asmirnou/gardtec-keypad/gardtec/gardtec.pdf

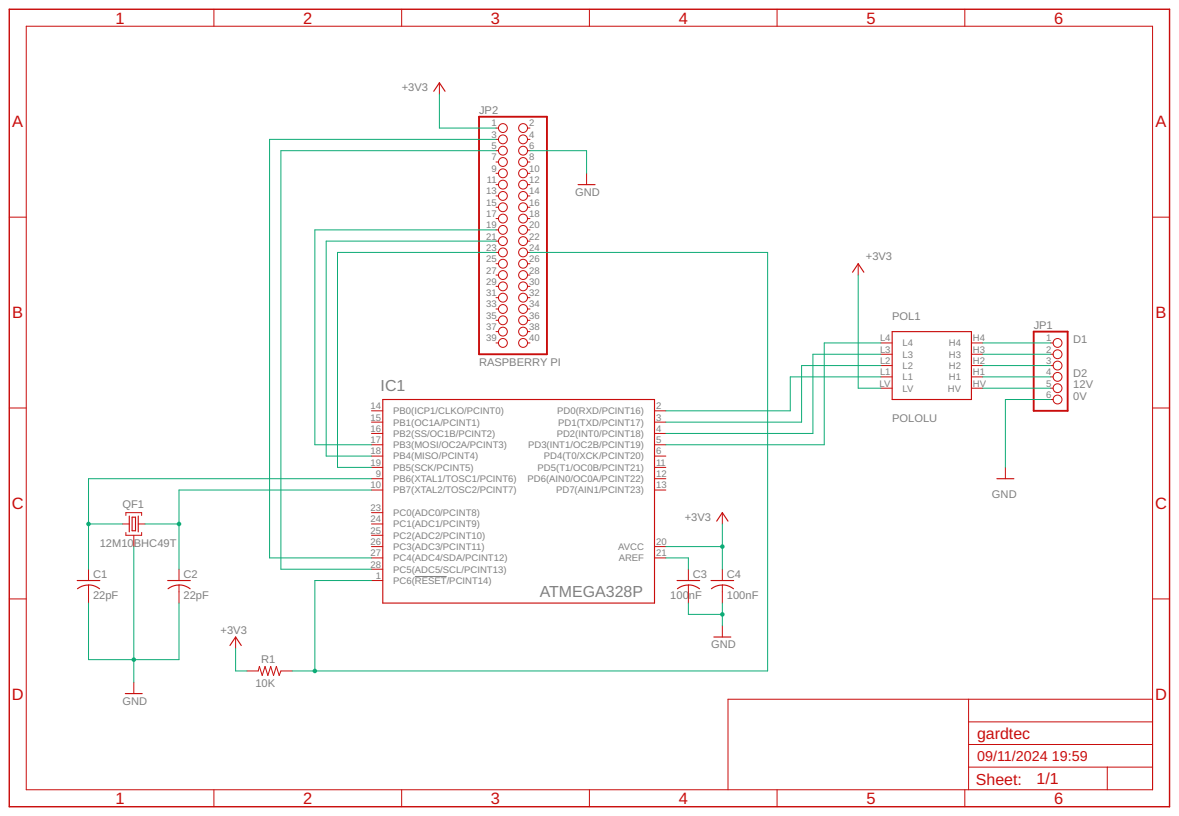
[picture p2: page 1]
