asmirnou/gardtec-keypad/gardtec/gardtec.sch

## EAGLE design gardtec/gardtec.sch (2024-11-09)

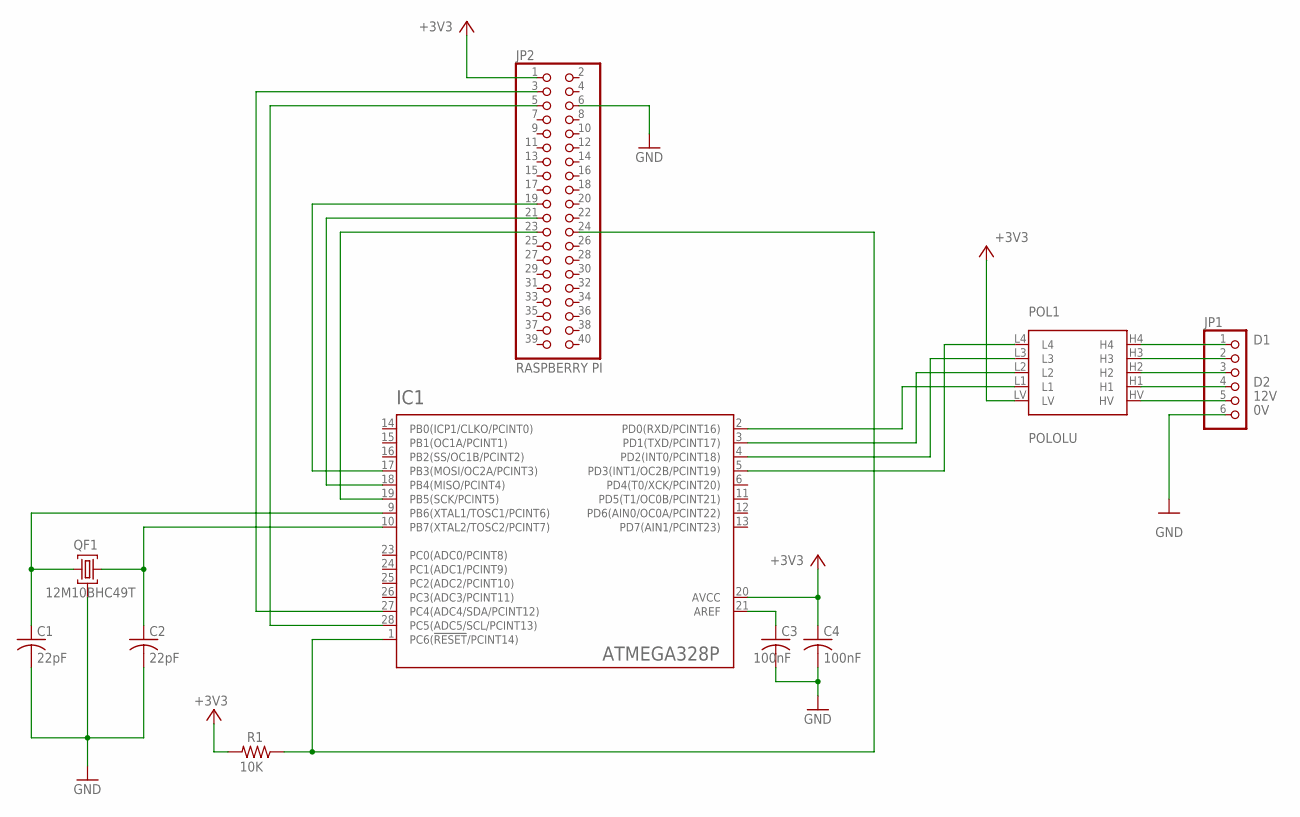
[picture p3: schematic gardtec.sch]

Parts:
C1, C2: 22pF; C0805
C3, C4: 100nF; C0805
IC1: ATMEGA328P; DIL28
JP1: PINHD-1X6; 1X06
JP2: RASPBERRY PI; 2X20
POL1: POLOLU
QF1: 12M10BHC49T; HC49U
R1: 10K; R0805

Connections:
0V: C1.2, C2.2, C3.2, C4.2, JP1.6, QF1.2
12V: JP1.5, POL1.HV
+3V3: C4.1, IC1.20 (AVCC), JP2.1, POL1.LV, R1.2
D1: JP1.1, POL1.H4
D2: JP1.4, POL1.H1
GND: JP2.6
unnamed: IC1.2 (PD0(RXD/PCINT16)), POL1.L1
unnamed: IC1.3 (PD1(TXD/PCINT17)), POL1.L2
unnamed: IC1.4 (PD2(INT0/PCINT18)), POL1.L3
unnamed: IC1.5 (PD3(INT1/OC2B/PCINT19)), POL1.L4
unnamed: C3.1, IC1.21 (AREF)
unnamed: C1.1, IC1.9 (PB6(XTAL1/TOSC1/PCINT6)), QF1.1
unnamed: C2.1, IC1.10 (PB7(XTAL2/TOSC2/PCINT7)), QF1.3
unnamed: IC1.1 (PC6(!RESET!/PCINT14)), JP2.24, R1.1
unnamed: JP1.2, POL1.H3
unnamed: IC1.27 (PC4(ADC4/SDA/PCINT12)), JP2.3
unnamed: IC1.28 (PC5(ADC5/SCL/PCINT13)), JP2.5
unnamed: IC1.17 (PB3(MOSI/OC2A/PCINT3)), JP2.19
unnamed: IC1.19 (PB5(SCK/PCINT5)), JP2.23
unnamed: IC1.18 (PB4(MISO/PCINT4)), JP2.21
N/C: JP1.3, POL1.H2
